prabh124/StarStruck/README.md

# StarStruck
Team 1104G's VEX Star Struck robot files including the World Championship robot code, files used for laser cutting polycarbonate, as well as the engineering notebook used.
