prabh124/StarStruck/Lasercut Files/Forks.DXF

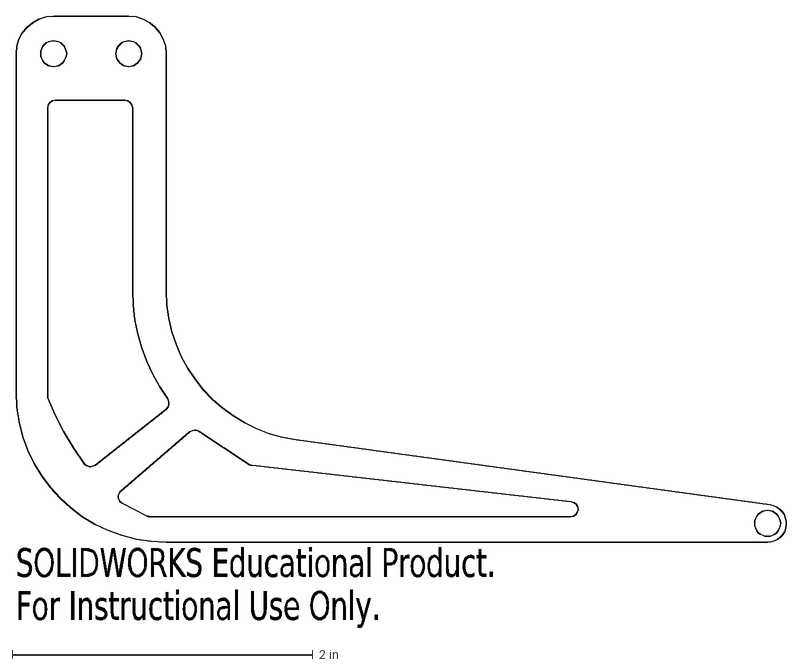
[picture p1: CAD file, 2018-05-19]
Lasercut Files/Forks.DXF
SOLIDWORKS Educational Product.
For Instructional Use Only.
