prabh124/StarStruck/Lasercut Files/CLAW.DXF

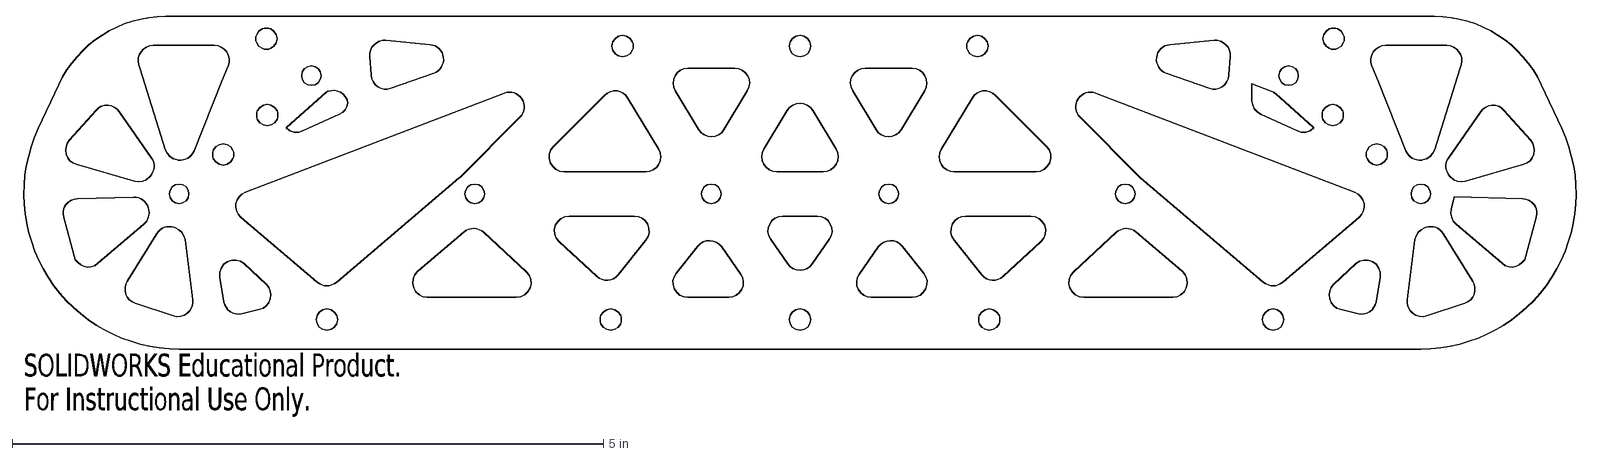
[picture p2: CAD file, 2018-05-19]
Lasercut Files/CLAW.DXF
SOLIDWORKS Educational Product.
For Instructional Use Only.
