prabh124/StarStruck/Lasercut Files/GearAttachment.DXF

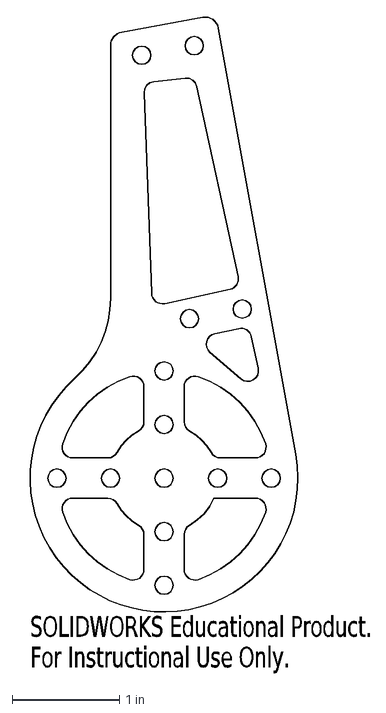
[picture p3: CAD file, 2018-05-19]
Lasercut Files/GearAttachment.DXF
SOLIDWORKS Educational Product.
For Instructional Use Only.
