prabh124/StarStruck/Lasercut Files/ClawTip.DXF

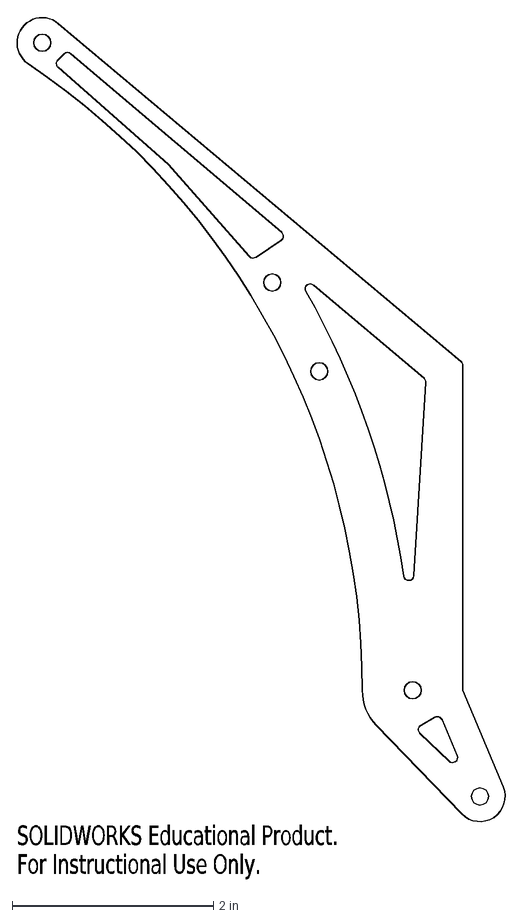
[picture p4: CAD file, 2018-05-19]
Lasercut Files/ClawTip.DXF
SOLIDWORKS Educational Product.
For Instructional Use Only.
