prabh124/StarStruck/Worlds Code/Autons.c

//Autonomous code file


void StandardAuto(int Side){

Lift_PositionCount = 1;
SetDriveControl(Line, 20, 1.5);
ClawPos = Closed;
wait1Msec(1500);
Lift_PositionCount = 4;
SetDriveControl(Rotation, 40*-Side, 1);
//RampUp(B);
//SetDriveControl(Line, 30*B, 1);
SetDriveControl(Rotation, 80*-Side, 1.5);
RampUp(B);
SetDriveControl(Line, 20*B, 1);
Lift_PositionCount = -1;
wait1Msec(1500);
Lift_PositionCount = 1;
}

void Block(){

ClawPos = Open;
wait1Msec(100);
Lift_PositionCount = 2;
SetDriveControl(Line, 54*B, 1.75);
Dump();
}

void NewAuto(int Side){

}

void Elims_FrontAuto(int Side){
}

void None(){
}

void Elims_BackAuto(int Side){

}

void Skills(int side){
//First load
Lift_PositionCount = 1;
SetDriveControl(Line, 20*B, 3);
ClawPos = Open;
wait1Msec(1500);
ClawPos = Closed;
wait1Msec(1000);
Lift_PositionCount = 4;
RampUp(B);
SetDriveControl(Line, 35*B, 1);
wait1Msec(500);
Dump();
wait1Msec(300);

//Second load
SetDriveControl(Line, 2*B, 0.1);
wait1Msec(200);
ClawPos = Mid;
SetDriveControl(Line, 27, 1);
wait1Msec(600);
ClawPos = Closed;
wait1Msec(500);
Lift_PositionCount = 4;
RampUp(B);
SetDriveControl(Line, 34*B, 1);
wait1Msec(500);
Dump();
wait1Msec(300);

//Third load
Lift_PositionCount = 2;
ClawPos = Mid;
wait1Msec(400);
SetDriveControl(Line, 1.5*B, 0.1);
wait1Msec(200);
SetDriveControl(Line, 4, 0.25);
wait1Msec(200);
SetDriveControl(Rotation, 90*-Side, 1);
wait1Msec(500);
Lift_PositionCount = 1;
wait1Msec(300);
SetDriveControl(Line, 7, 0.25);
wait1Msec(200);
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
Lift_PositionCount = 4;
wait1Msec(300);
SetDriveControl(Line, 25*B, 1.75);
wait1Msec(1000);
SetDriveControl(Line, 8, 1);
wait1Msec(600);
SetDriveControl(Rotation, 45*Side, 1);
wait1Msec(500);
SetDriveControl(Line, 8*B, 1);
wait1Msec(600);
Lift_PositionCount = 3;
wait1Msec(300);







}
