prabh124/StarStruck/(commit log)

2018-05-19 Main driver control code
2018-05-19 Functions used for autonomous and driver
2018-05-19 Create Lasercut files
